joeymariano/circuit-bent-fuzz-controller/HARDWARE-V2-NOTES.md

# Bend Platform v2: firmware notes

Notes from the v2 PCB review (`bend Platform-v2.eprj`, Oct 2026). The v2 board changes
how the bends are switched. The firmware has been updated for it (`#define BOARD_V2 1`).

## What changed in hardware

| | v1 board | v2 board |
|---|---|---|
| Bend switch | 2N7000 directly across the bend | **CD4066BM96** analog switch (U2, LCSC C54755), control driven by an **AO3400A** (Q2/Q3) with a 10k pull-up to 9 V |
| LED interrupt | 2N7000 (T1) | AO3400A (Q1) low-side switch: gate D1, drain → **LED-** pad, source → GND |
| Gate resistors | 220 Ω series | none |
| Gate pull-downs | none | none (handled in software, see below) |
| Power | — | 9 V → SS14 reverse-polarity diode → L78M05 → XIAO 5V pin |

Pin map: BTN-1 = D2, BTN-2 = D3, MODE = D9, Q1 = D1.

On the PCB, D5 → Q3 → CD4066 switch A → the **BND-1** pads, and D4 → Q2 → switch B → the
**BND-2** pads. The firmware's `bends[]` array is ordered to match, so BTN-1 works BND-1 and
BTN-2 works BND-2.

## ⚠️ Bend logic is inverted on v2

The AO3400A pulls the CD4066 control pin low when its gate is high:

| Gate pin (D4/D5) | MOSFET | CD4066 control | Bend |
|---|---|---|---|
| **HIGH** | on | pulled to 0 V | **OPEN (bend off)** |
| **LOW** | off | pulled to 9 V by 10k | **CLOSED (bend on)** |

This is done in firmware. `BEND_ON` / `BEND_OFF` are LOW / HIGH when `BOARD_V2` is 1,
`setSwitch()` uses them, and `setup()` starts both gates at `BEND_OFF` (HIGH). Set
`#define BOARD_V2 0` to go back to the v1 polarity.

The LED interrupt (Q1) is a plain low-side switch: its source is on the board's GND, so
D1 HIGH = LED path closed (LED on), D1 LOW = LED dark. The pad next to **LED-** is tied to GND.

## Gate pins: set them first in `setup()`

There are no external gate pull-downs. The SAMD21 tri-states its pins while in reset and keeps
them floating until firmware configures them: at power-up, during the bootloader's ~0.5 s
window, and while flashing. During that window the bends and the LED may glitch briefly. This
is harmless; at most about 0.9 mA flows through the 10k pull-ups.

To keep the window short, `setup()` configures D1, D4 and D5 **before anything else**,
including `Serial.begin()`. It writes each level before switching the pin to OUTPUT. If the startup glitch turns out to be audible, add
100k gate-to-source resistors on Q2/Q3 in a future board revision.

## Using the bends (CD4066 limits, from the TI datasheet)

- The pedal being bent **must share ground** with the platform (the GND pad).
- Bend-point signals must stay **between 0 V and 9 V** relative to that ground. Signals outside
  that range get clipped, or can latch up the CD4066.
- At most **10 mA** through each switch. On-resistance is about 180–400 Ω at 9 V.

## Power cautions

- **Don't plug in USB while the 9 V battery is connected.** The XIAO's 5V pin is its USB rail,
  and USB would back-feed into the L78M05 output.
- A reversed battery is blocked by the SS14 (D1). The diode drops about 0.3 V, so the
  regulator stops regulating once the battery sags to about 7.4 V.
