joeymariano/circuit-bent-fuzz-controller/docs/art/3up-new-nmlstyl-sticker.png

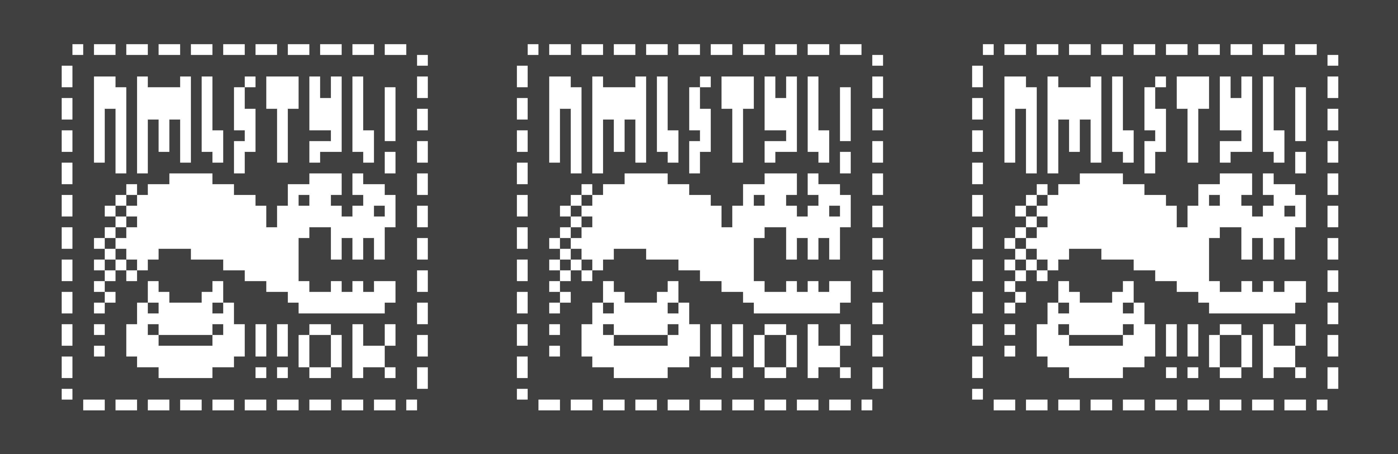
docs/art/3up-new-nmlstyl-sticker.png
