joeymariano/circuit-bent-fuzz-controller/docs/bend-locations/back-of-fuzz-original.jpg

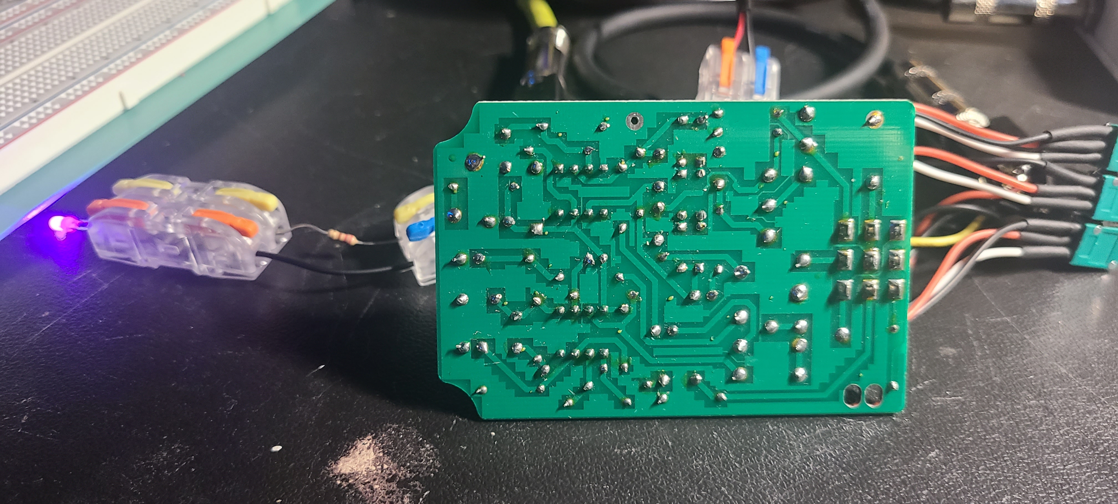
docs/bend-locations/back-of-fuzz-original.jpg
