joeymariano/circuit-bent-fuzz-controller/docs/layouts-schematics/SCH_Schematic1_1-P1_2026-10-14.png

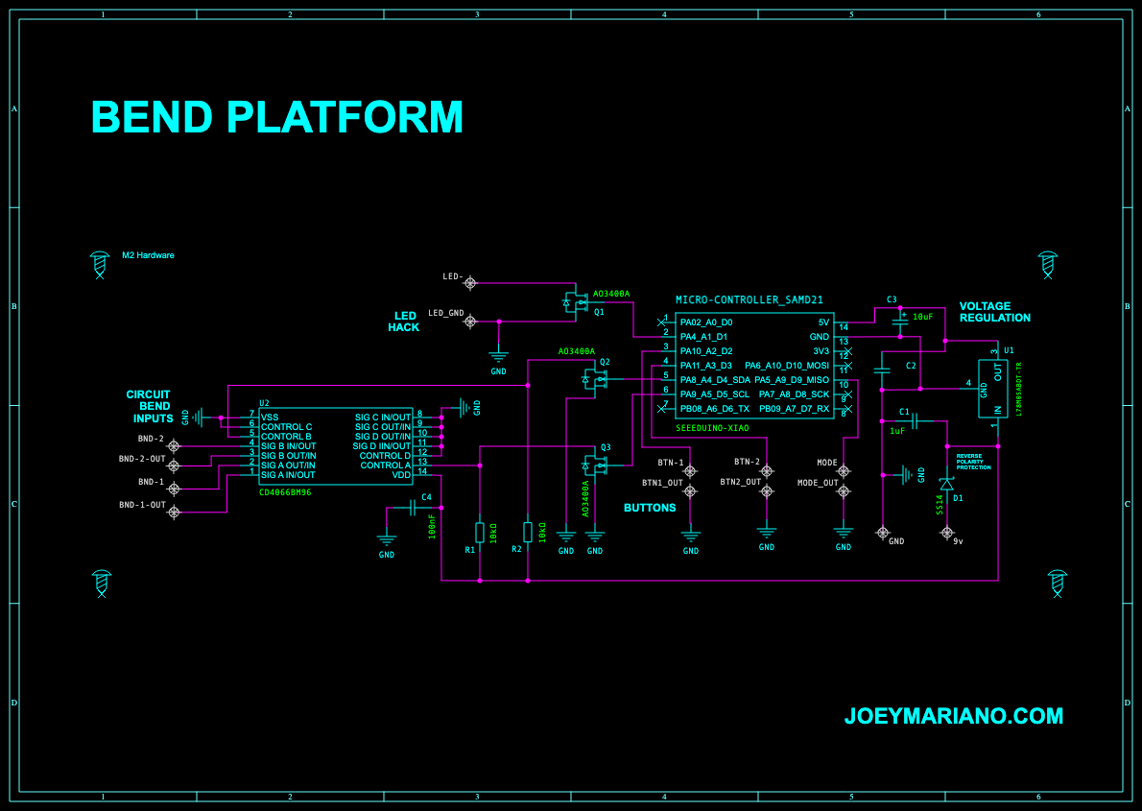
docs/layouts-schematics/SCH_Schematic1_1-P1_2026-10-14.png
