joeymariano/circuit-bent-fuzz-controller/docs/layouts-schematics/BOM_Board1_PCB1_2026-10-14.xlsx

No. | Quantity | Comment | Designator | Footprint | Value | Manufacturer Part | Manufacturer | Supplier Part | Supplier | LCSC Stock | LCSC Price | JLCPCB Stock | JLCPCB Price
1 | 1 | 1uF | C1 | C0402 | 1uF | CL05A105KA5NQNC | SAMSUNG(三星) | C52923 | LCSC |  |  | 7601858 | 0.0013
2 | 1 | 100nF | C2 | C0402 | 100nF | CC0402KRX7R9BB104 | YAGEO(国巨) | C131394 | LCSC |  |  | 7838576 | 0.0015
3 | 1 | 10uF | C3 | C0603 | 10uF | CL10A106KP8NNNC | SAMSUNG(三星) | C19702 | LCSC |  |  | 9401984 | 0.0047
4 | 1 | 100nF | C4 | C0402 | 100nF | CL05B104KB54PNC | SAMSUNG(三星) | C307331 | LCSC |  |  | 14664338 | 0.0014
5 | 1 | SS14 | D1 | SMA_L4.2-W2.6-LS5.0-RD_1 |  | SS14 | MDD(辰达半导体) | C2480 | LCSC |  |  | 1364694 | 0.0029
6 | 4 | Screw-Hole-M2 | H1,H2,H3,H4 | Screw-Hole-M2 |  |  |  |  |  |  | 0.4223
7 | 1 | SEEEDUINO-XIAO | MICRO-CONTROLLER_SAMD21 | MOUDLE14P-2.54-21X17.8MM |  |  |  |  |  |  | 0.4223
8 | 3 | AO3400A | Q1,Q2,Q3 | SOT-23-3_L2.9-W1.3-P1.90-LS2.4-BR |  | AO3400A | AOS | C20917 | LCSC |  |  | 774401 | 0.0134
9 | 2 | 10kΩ | R1,R2 | R0805 | 10kΩ | 0805W8F1002T5E | UNI-ROYAL(厚声) | C17414 | LCSC |  |  | 57234196 | 0.0005
10 | 1 | L78M05ABDT-TR | U1 | TO-252-2_L6.5-W6.1-P4.58-LS10.0-TL |  | L78M05ABDT-TR | ST(意法半导体) | C58069 | LCSC |  |  | 148925 | 0.0309
11 | 1 | CD4066BM96 | U2 | SOIC-14_L8.7-W3.9-P1.27-LS6.0-BL |  | CD4066BM96 | TI(德州仪器) | C54755 | LCSC |  |  | 10508 | 0.0287
