joeymariano/circuit-bent-fuzz-controller/docs/layouts-schematics/SCH_Schematic1_2026-07-22.pdf

## PA02_A0_D0 1 PA4_A1_D1 2

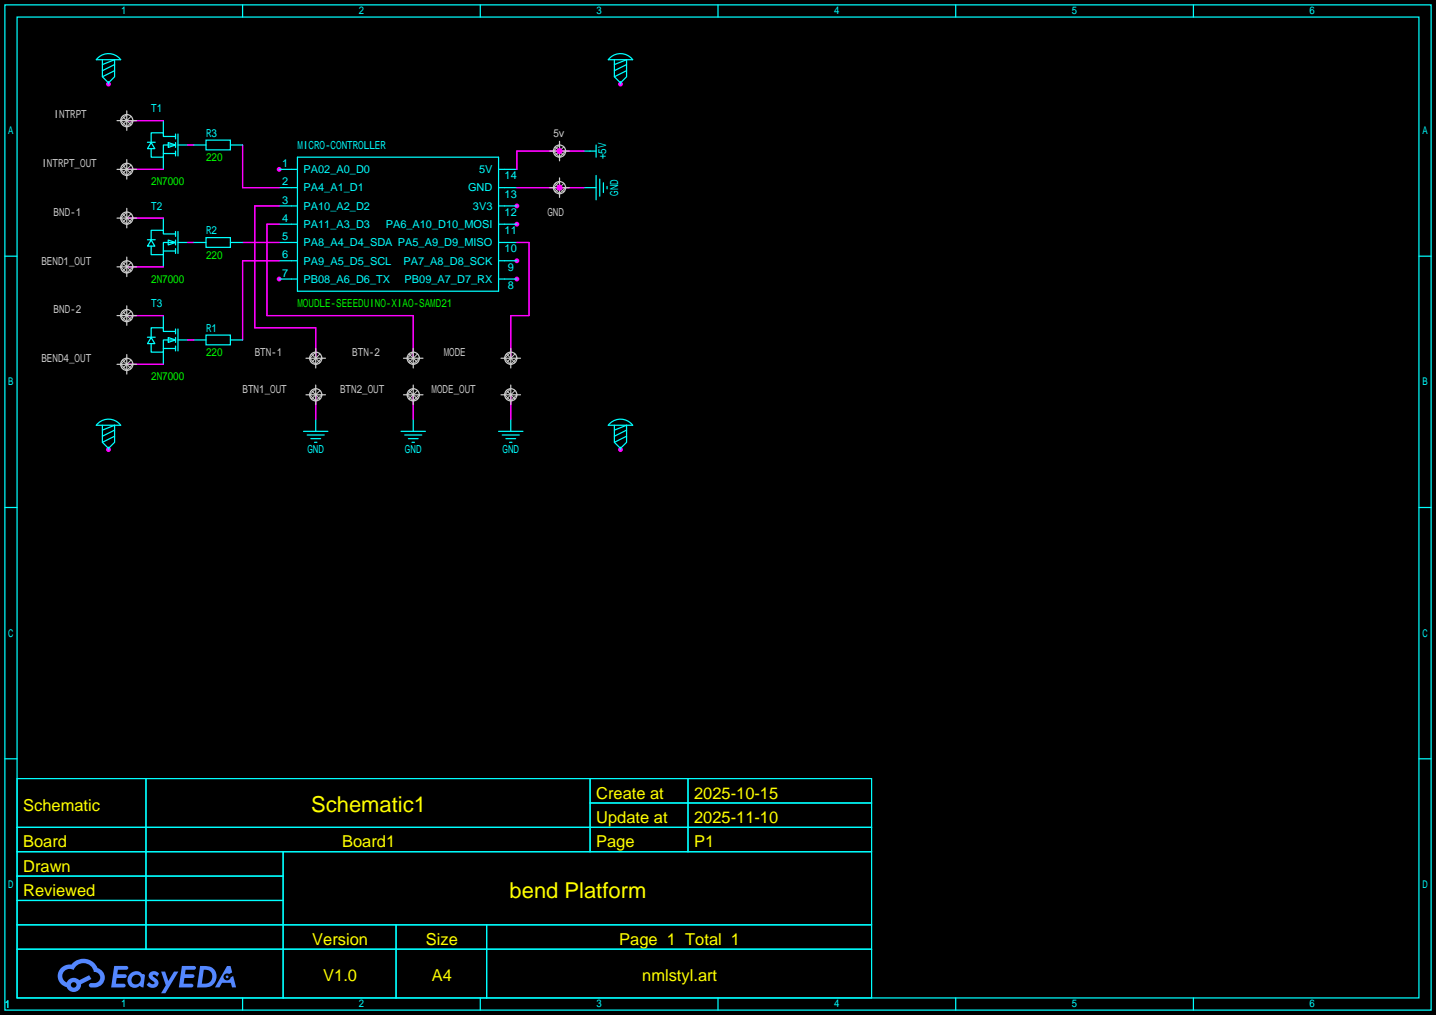
[picture p5: page 1]

Schematic | Schematic1 | Create at | 2025-10-15

Update at | 2025-11-10

Board | Board1 | Page | P1
Drawn | | bend Platform
Reviewed

Version | Size | Page 1 Total 1
V1.0 | A4 | nmlstyl.art
