joeymariano/circuit-bent-fuzz-controller/docs/layouts-schematics/prototype/SCH_Schematic2_2026-07-22.pdf

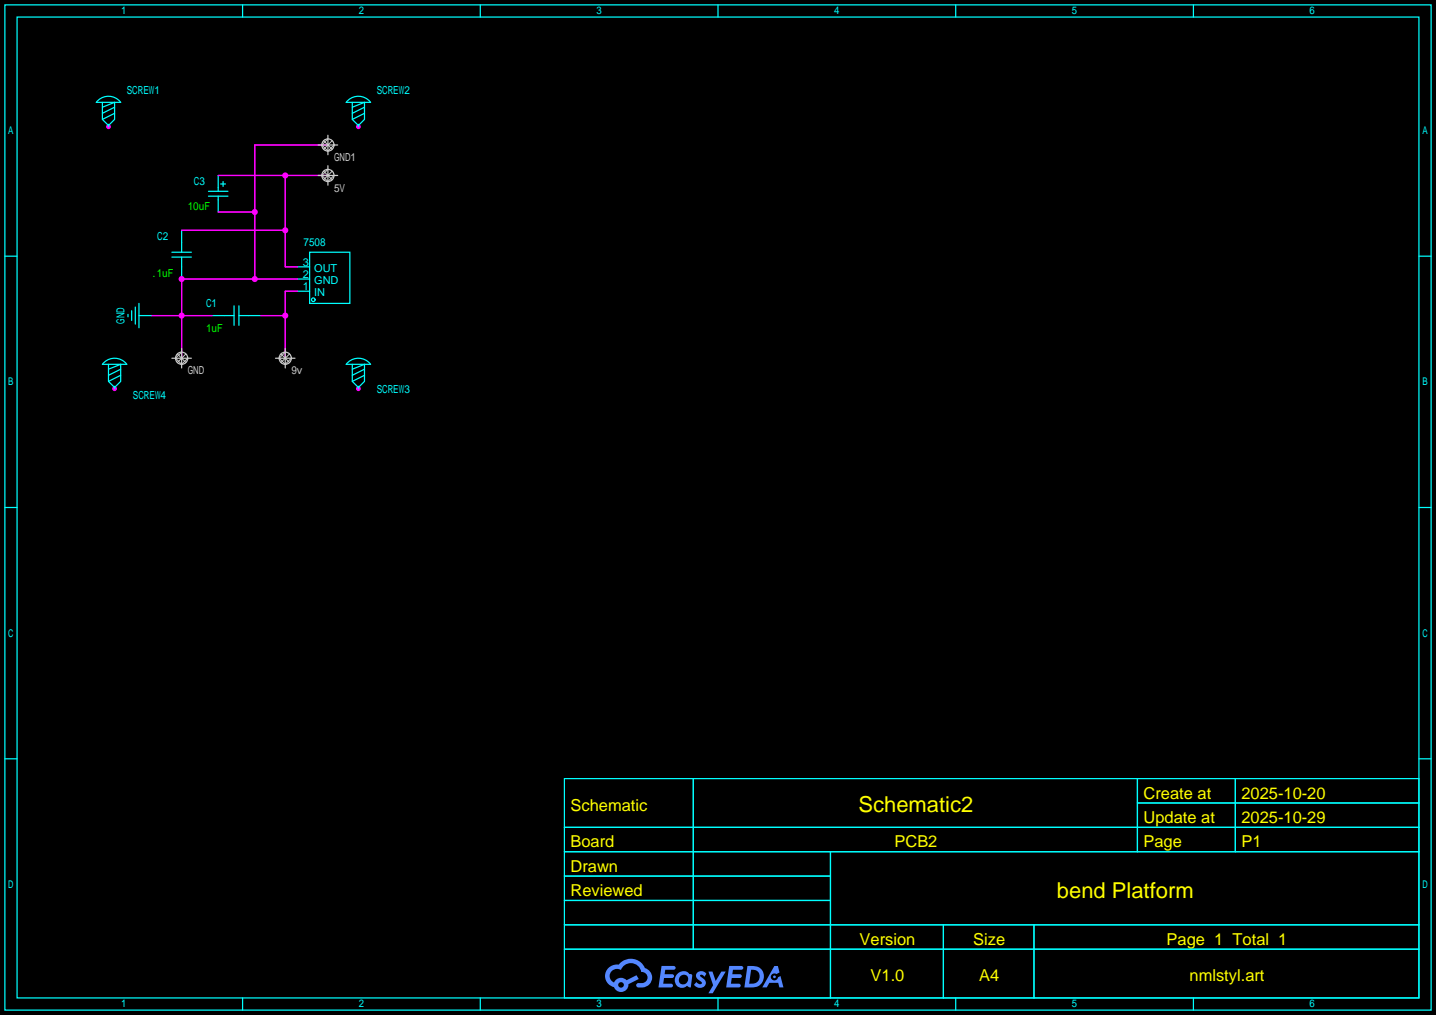
[picture p6: page 1]

Schematic | Schematic2 | Create at | 2025-10-20

Update at | 2025-10-29

Board | PCB2 | Page | P1
Drawn | | bend Platform
Reviewed

Version | Size | Page 1 Total 1
V1.0 | A4 | nmlstyl.art
