joeymariano/circuit-bent-fuzz-controller/docs/layouts-schematics/SCH_Schematic1_2026-10-14.pdf

# BEND PLATFORM

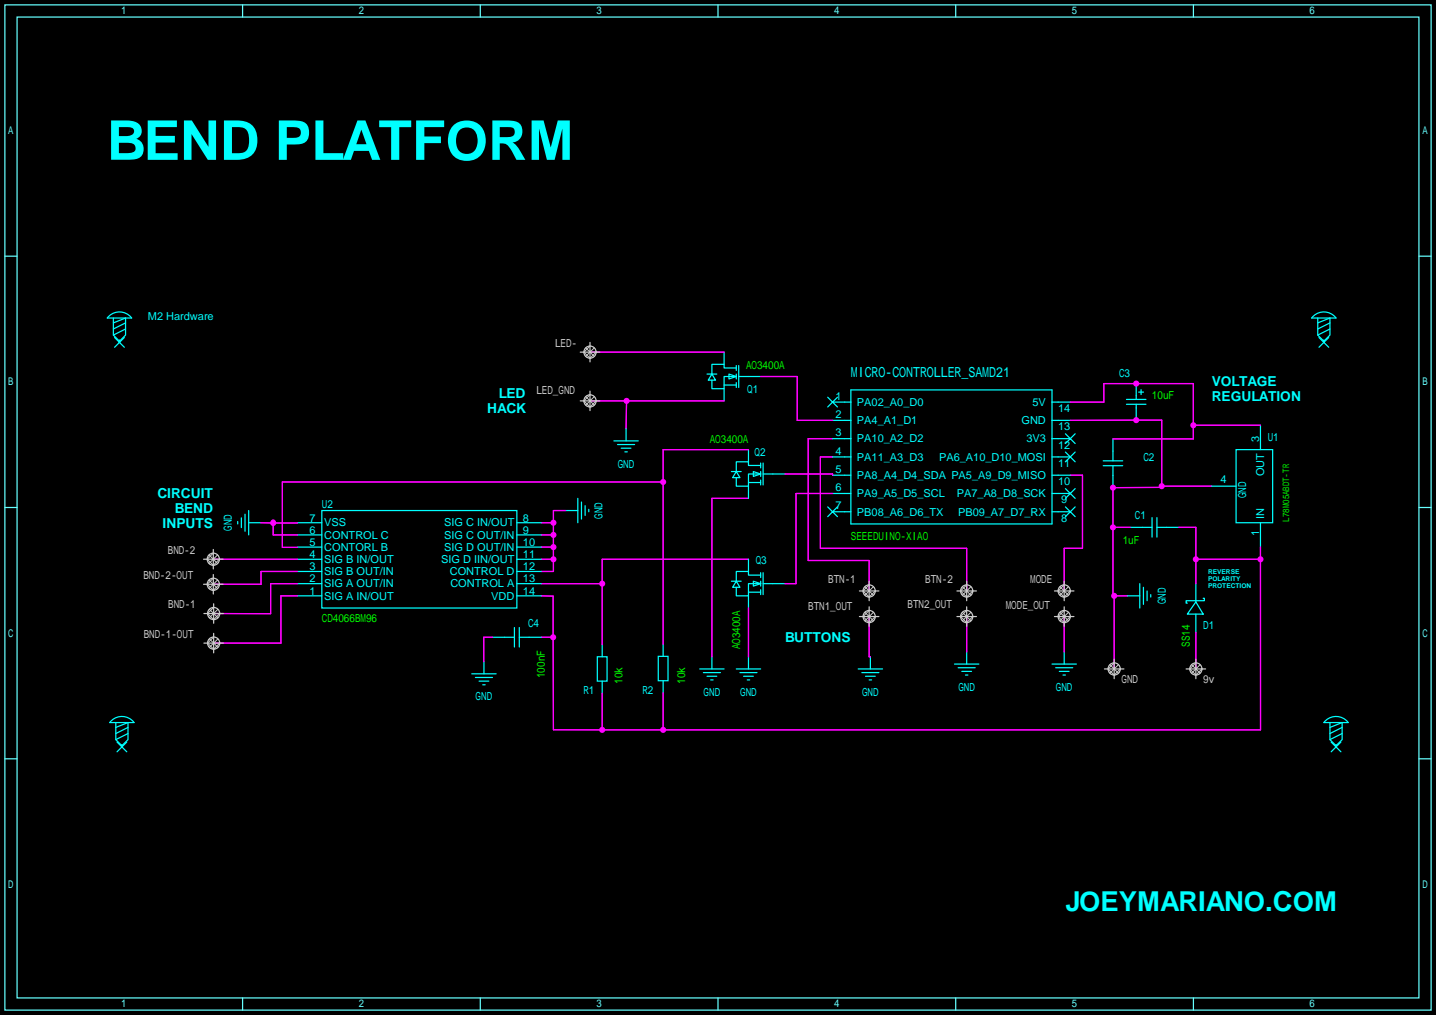
[picture p7: page 1]
