joeymariano/circuit-bent-fuzz-controller/(list of files, drawings)

Other design files:
docs/layouts-schematics/bend Platform.eprj
