joeymariano/circuit-bent-fuzz-controller/docs/parts-data/landtone-kit/Landtone-Fuzz-Wiring.jpg

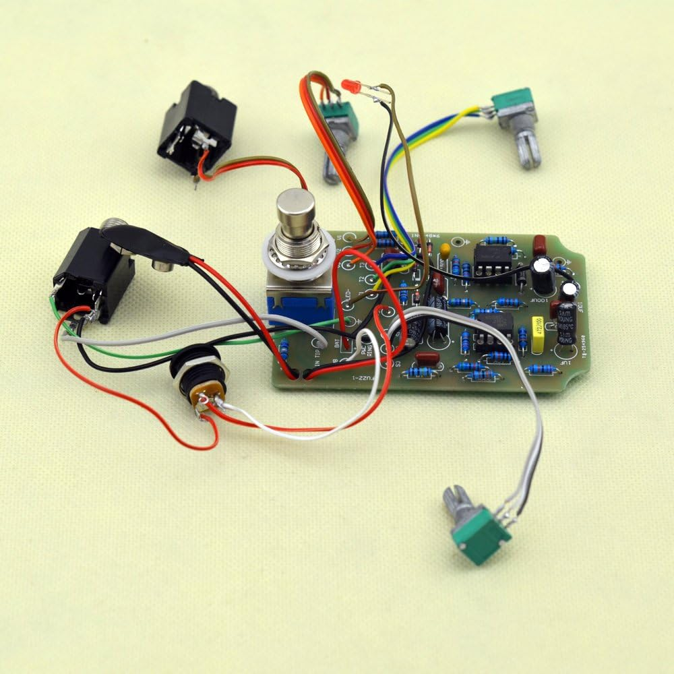
docs/parts-data/landtone-kit/Landtone-Fuzz-Wiring.jpg
