joeymariano/circuit-bent-fuzz-controller/docs/prototype-wiring/1000009801.jpg

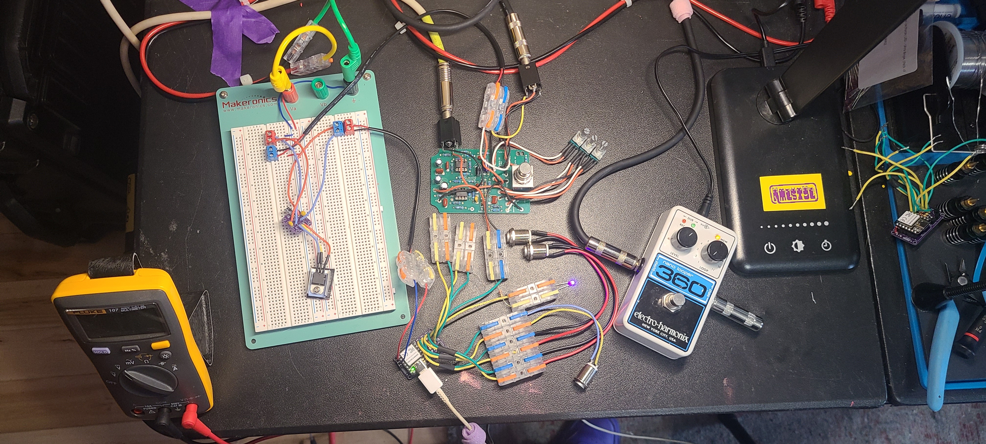
docs/prototype-wiring/1000009801.jpg
