joeymariano/circuit-bent-fuzz-controller/docs/prototype-wiring/1000009802.jpg

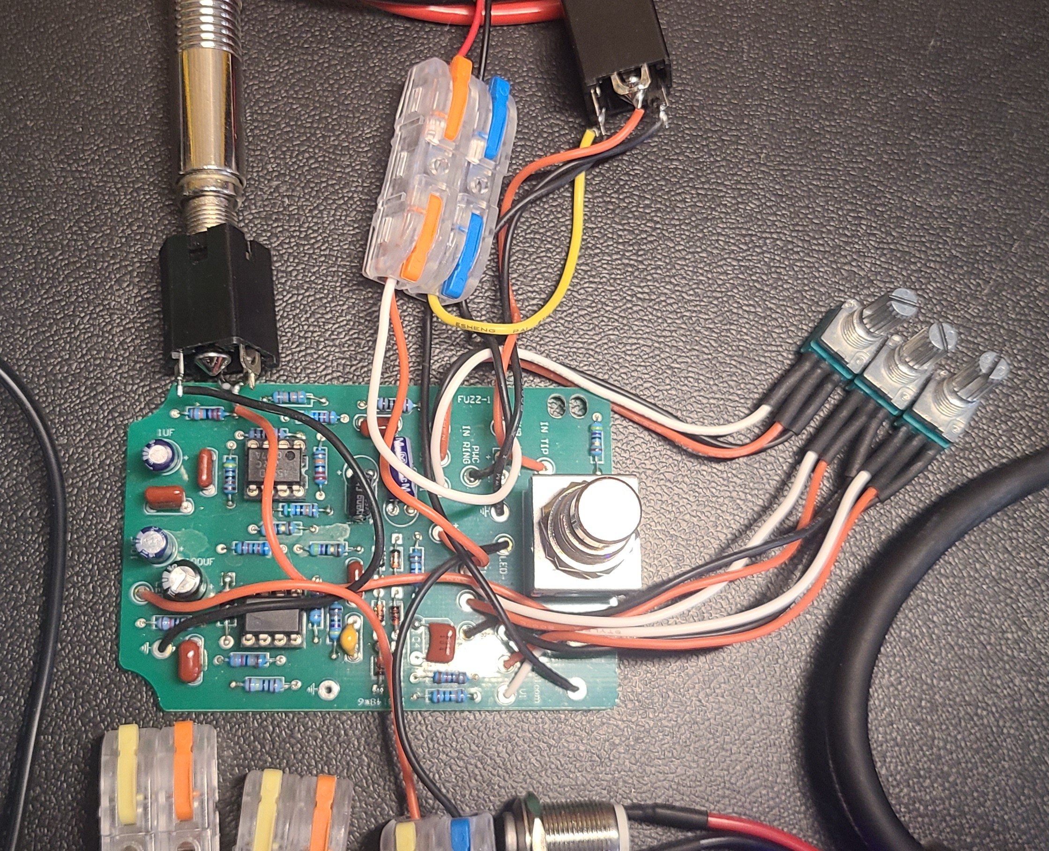
docs/prototype-wiring/1000009802.jpg
