joeymariano/circuit-bent-fuzz-controller/docs/prototype-wiring/1000009803.jpg

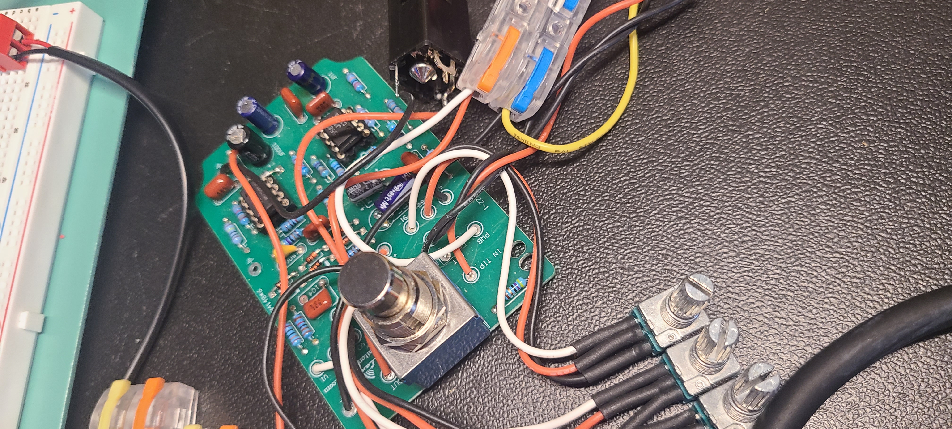
docs/prototype-wiring/1000009803.jpg
