joeymariano/circuit-bent-fuzz-controller/docs/prototype-wiring/1000009804.jpg

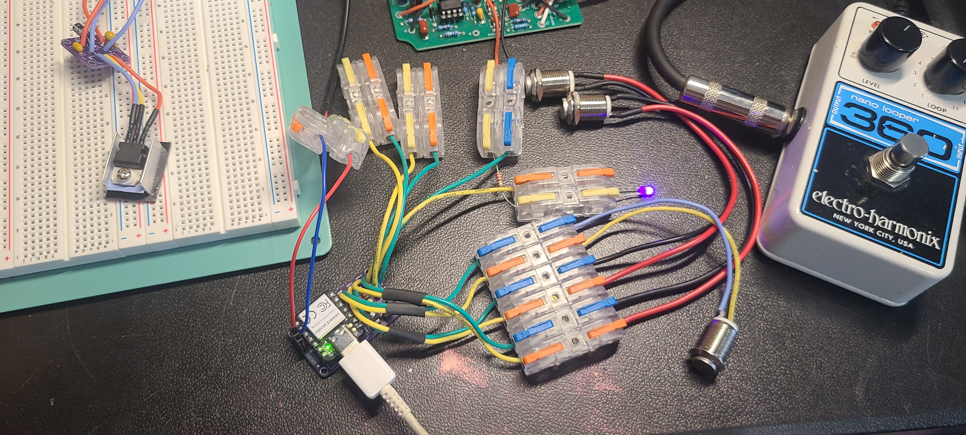
docs/prototype-wiring/1000009804.jpg
