joeymariano/circuit-bent-fuzz-controller/(commit log)

2025-09-01 header material
2025-09-04 toggles main led whenever mode is hit
2026-07-30 rewrite firmware: fix PCB pin map, DRY/KISS refactor, T1 mode-blink
    [circuit-bent-fuzz.ino]
2026-07-30 organizing project files
    [bend Platform.eprj]
2026-10-13 Port firmware and docs to Bend Platform v2 board
    - Firmware: bends now drive a CD4066 via AO3400A level shifters, so
    bend logic is active-LOW (BOARD_V2 / BEND_ON / BEND_OFF); gate pins
    are set before anything else in setup(); bend 1/2 pins remapped to
    D5/D4 to match the BND-1/BND-2 pads.
    - Add HARDWARE-V2-NOTES.md (v2 board review: CD4066BM96 on U2, Q1 as
    low-side LED switch to GND, bend limits, power cautions).
    - README: v2 pin map and LED-interrupt wiring via the LED- pad.
    - Reorganize docs: v1 prototype files under layouts-schematics/prototype,
    datasheets split into parts-data/chips and parts-data/transistors.
2026-10-14 updated pcb layout and schematic
